Abo-AL-Yaseen/Autonomous-Medicine-Dispensing-Robot/raspberry_controller/database/README.md

This SQLite schema and `hospital.db` belong to the legacy Raspberry mission and
navigation implementation. They remain in place for compatibility and are not
the source of truth for scheduled missions.

The RTC-driven `MissionScheduler` and `MissionExecutor` use Laravel over HTTP
for claiming and the limited `pending -> in_progress` transition. They must not
query this database or copy Laravel mission records into it.
