Abo-AL-Yaseen/Autonomous-Medicine-Dispensing-Robot/aruco_markers/11_ROOM_1.png

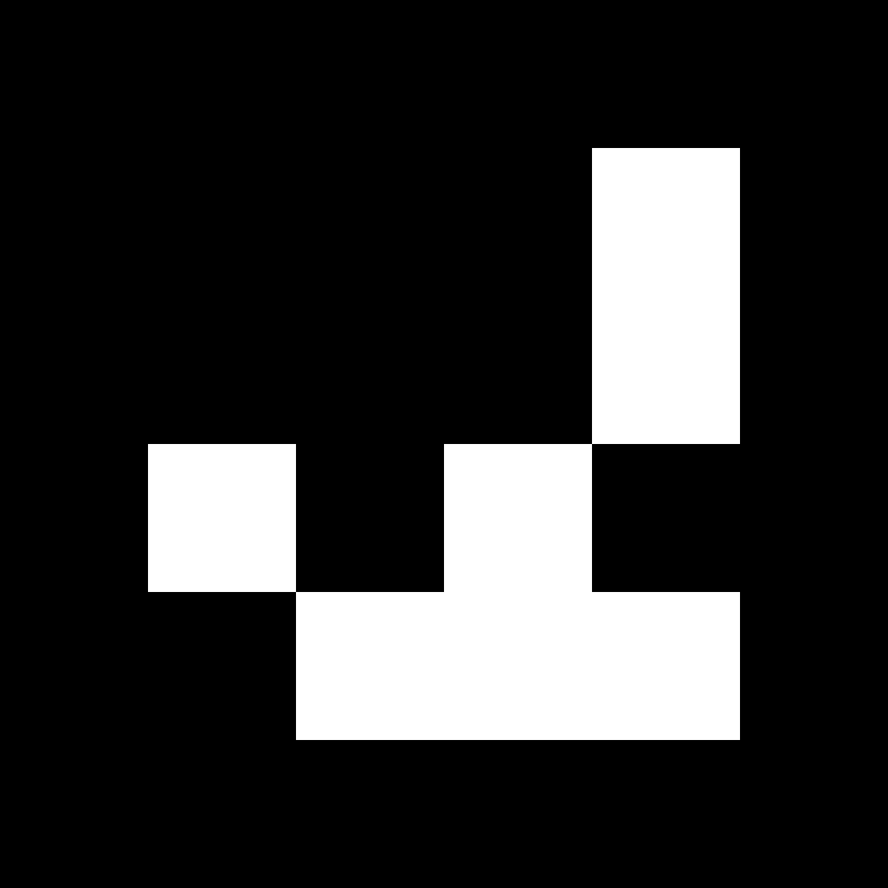
aruco_markers/11_ROOM_1.png
