Abo-AL-Yaseen/Autonomous-Medicine-Dispensing-Robot/aruco_markers/12_ROOM_2.png

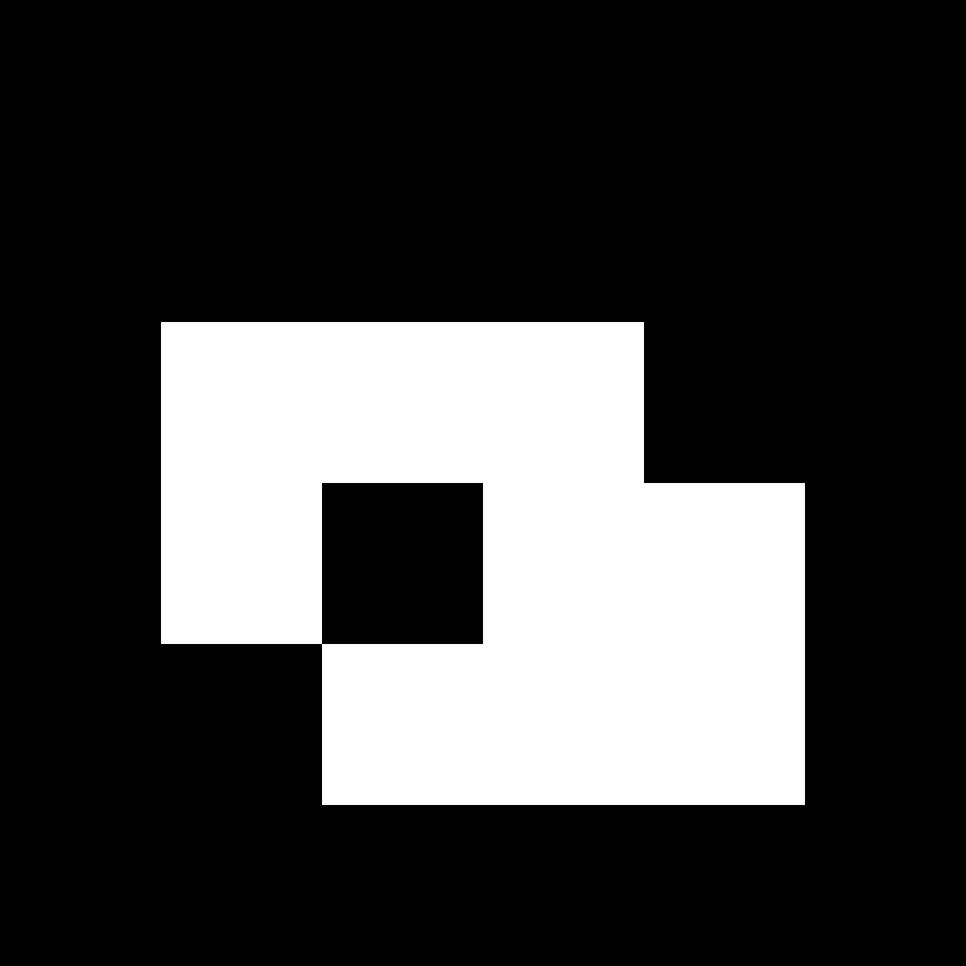
aruco_markers/12_ROOM_2.png
