Abo-AL-Yaseen/Autonomous-Medicine-Dispensing-Robot/aruco_markers/13_ROOM_3.png

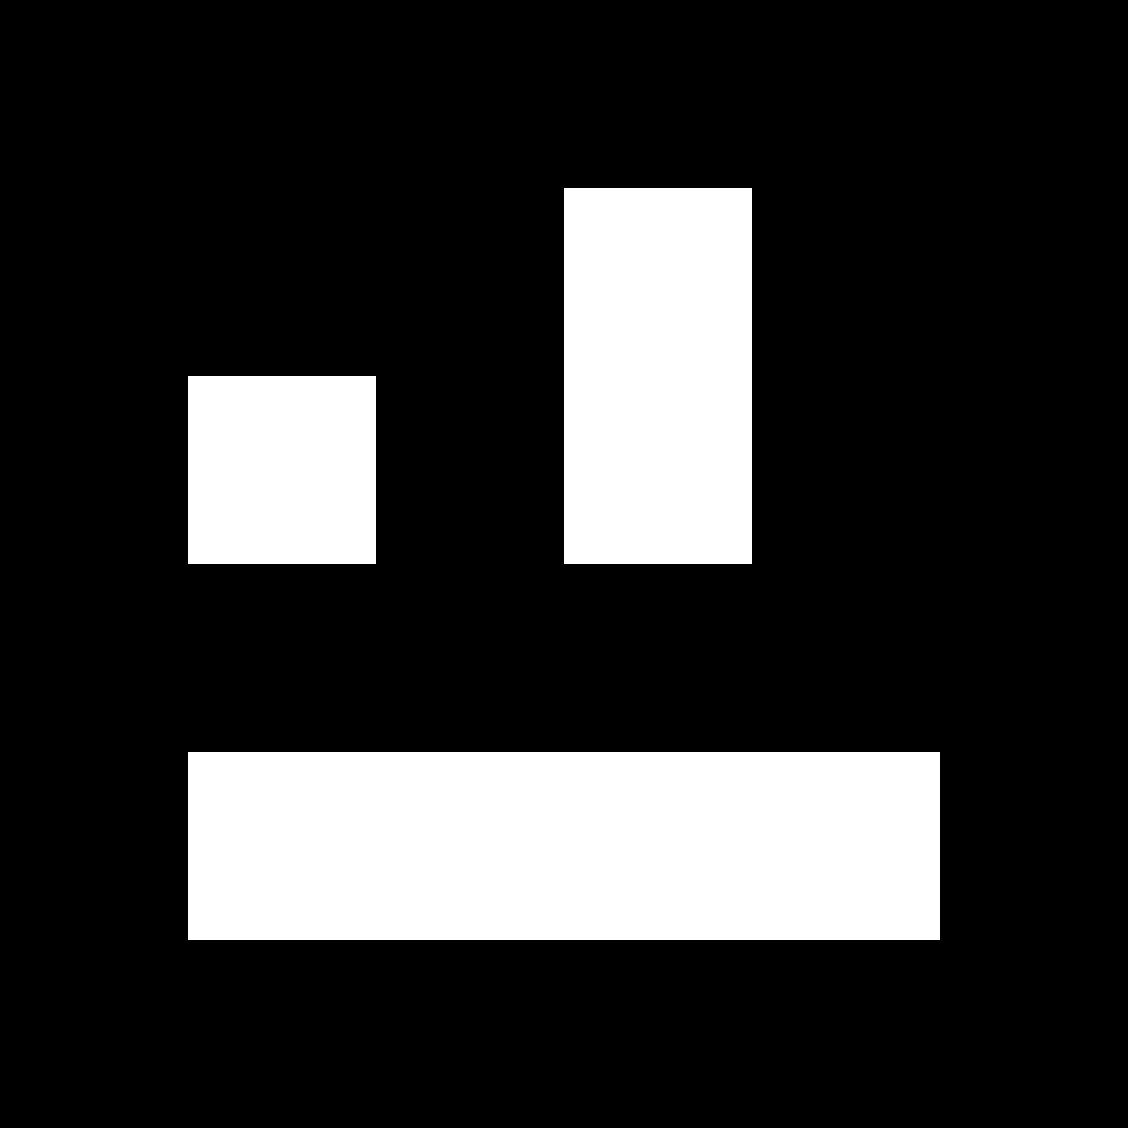
aruco_markers/13_ROOM_3.png
