Abo-AL-Yaseen/Autonomous-Medicine-Dispensing-Robot/aruco_markers/14_ROOM_4.png

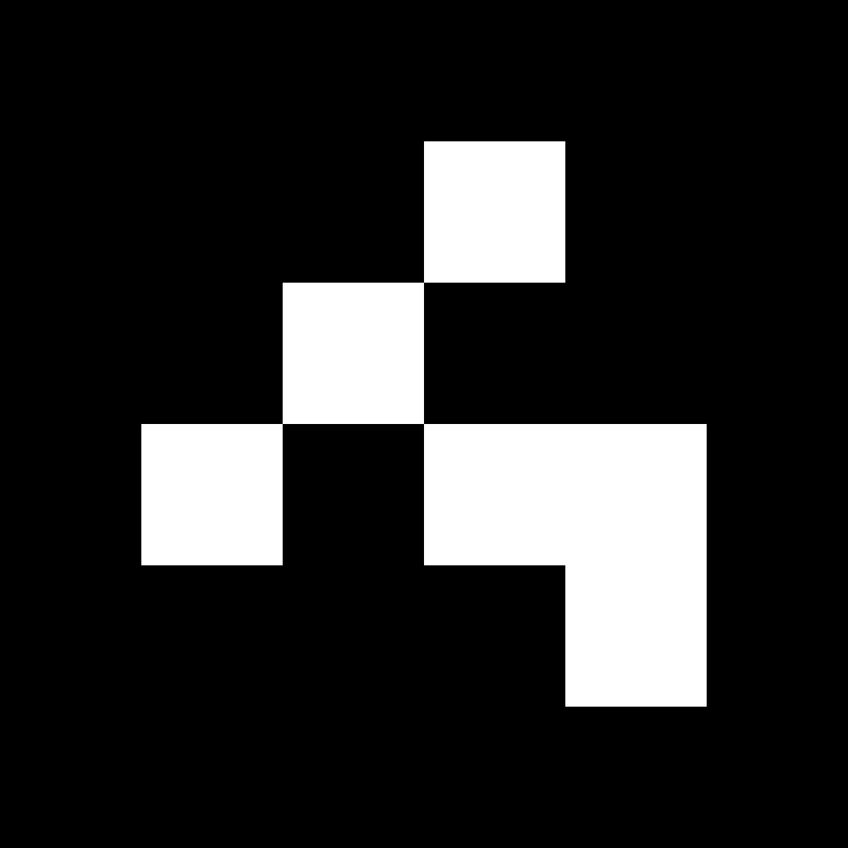
aruco_markers/14_ROOM_4.png
