Abo-AL-Yaseen/Autonomous-Medicine-Dispensing-Robot/aruco_markers/15_ROOM_5.png

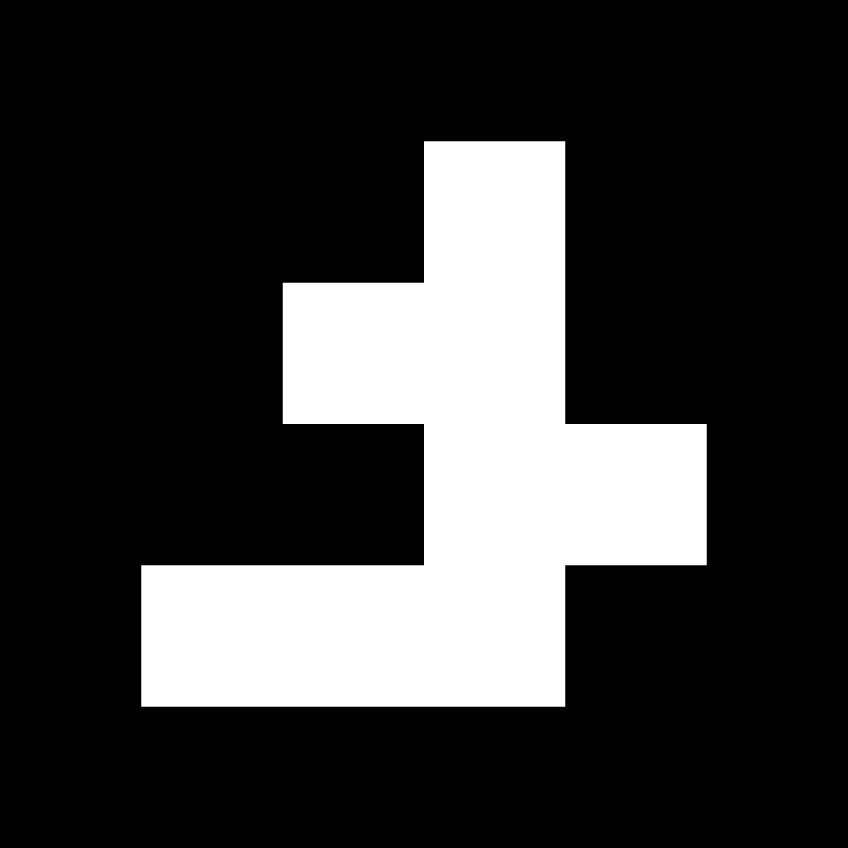
aruco_markers/15_ROOM_5.png
