Abo-AL-Yaseen/Autonomous-Medicine-Dispensing-Robot/esp32_controller/src/chair_control.h

#pragma once
#include <Arduino.h>

// أوضاع الكرسي
enum ChairMode { MODE_LECTURE, MODE_EXAM, MODE_GROUP };
enum ChairStatus { STATUS_IDLE, STATUS_MOVING, STATUS_DONE };

void initChair();
void calibrateGyro();
void moveToMode(String mode);
void setCurrentAngle(int angle);

// Getters
int         getCurrentAngle();
ChairStatus getChairStatus();
String      getCurrentMode();
