Abo-AL-Yaseen/Autonomous-Medicine-Dispensing-Robot/(commit log)

2026-07-16 Initial ESP32 and Raspberry Pi setup
2026-07-24 add tracking line sensor
2026-07-24 Add Arduino medicine dispenser controller
2026-07-27 Add serial protocol for Arduino medicine dispenser
2026-07-27 Add unified Raspberry Pi hardware controller
2026-07-28 Add Raspberry Pi FastAPI hardware service
2026-07-28 Tune line following motor speed
2026-07-30 Fix physical intersection turns
    [hardware_controller.py, main.cpp]
2026-08-10 Fix manual left and right steering mapping
    [main.cpp]
2026-08-10 Integrate ArUco camera service into FastAPI
2026-08-11 Add FastAPI live camera stream
2026-08-12 Fix fragmented ESP32 serial responses
    [hardware_controller.py]
2026-08-13 Add pill sensor confirmation to medicine dispenser
2026-08-13 Fix UNO dispenser declaration order
    [medicine_dispenser_uno.ino]
2026-08-13 Add temporary pill sensor diagnostics
2026-08-13 Tune pill sensor detection debounce
2026-08-13 Capture pill drops with pin change interrupts
2026-08-13 Fix dispenser sensor mapping
    [medicine_dispenser_uno.ino]
2026-08-16 Fix ESP32 structured command parsing
    [main.cpp]
2026-08-18 Add multi-medicine missions and dispenser calibration
2026-08-18 Add mobile dispenser calibration workflow
2026-08-19 Fix dispenser status response parsing
    [hardware_controller.py]
2026-08-19 Refresh HOME readiness from live camera
2026-08-19 Add ultrasonic water level monitoring
2026-08-23 Calibrate ultrasonic water level sensing
2026-08-23 Add manual water pump control
2026-08-23 Fix RTC system sync confirmation
    [api.py]
2026-08-23 Add live camera streaming to mobile app
2026-09-01 fix: improve U-turn line reacquisition reliability
    [main.cpp]
2026-09-01 fix: stop U-turn pivot on first line contact
    [main.cpp]
2026-09-01 fix: calibrate U-turn line search angle
    [main.cpp]
2026-09-01 feat: move water pump control to Arduino UNO
2026-09-02 fix: synchronize voice and restore navigation controls
    [api.py]
